Flopsstuff/voistic/(list of files, cad)

Other CAD files:
cad/voistic - tube.stl
cad/voistic - cap.stl
