Flopsstuff/voistic/(commit log)

2026-11-01 🎉 Initial commit
    voistic is a one-button Wi-Fi remote: an ESP32-S3 button that sleeps, recognises a
    gesture and talks to a Go server on the LAN. A hold streams the voice to the server,
    which transcribes it through Groq and pastes it into the active window. New firmware
    goes over the air, with rollback.
2026-11-01 📐 Add the case models, Wi-Fi signal reports and photos
    The tube and the cap are Onshape custom features, with the STLs as
    exported from them, and .mcp.json connects the FeatureScript MCP server.
    The button reports its Wi-Fi signal to the server. Photos and a short
    video show the parts and the prototype at work.
    [voistic - cap.stl, voistic - tube.stl]
2026-11-02 📐 Shrink the case and give the cap a snap-fit skirt
    The printed case fit with room to spare and its cap fell off. The body is
    now 22 × 18 × 80 mm with a 1 mm wall. The cap has a skirt all around with
    bumps that snap into dimples in the side walls, and the plate only presses
    on the stack.
    Claude-Session: https://claude.ai/code/session_01TWqRvKSs74rjiaw7r7Vu55
    [voistic - cap.stl, voistic - tube.stl]
2026-11-02 🪟 Run on Windows and publish releases from CI
    The server pastes and presses keys through Win32 on Windows and starts at
    login as a scheduled task, running a build with no console window. A new
    `key` action presses enter, tab or esc on macOS and Windows, so a config
    no longer depends on the system.
    CI tests the server on Linux, macOS and Windows and builds the firmware.
    A v* tag also publishes a release with an archive for each system, both
    firmwares and their checksums.
    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
2026-11-02 🔗 Pair only on request and share a network between servers
    A button now pairs only while `voistic pair` is waiting, even when the
    config names it. The firmware used to take the first server that answered
    mDNS, so a second server on the network could block pairing, or block a
    button whose server had moved. It now tries each one that answers.
    CI needed two fixes: the firmware platform is pinned, since newer ones
    bring Arduino core 3, which has no MDNS.IP, and the tests of Unix file
    modes are skipped on Windows, which has none.
    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
    [client.cpp]
2026-11-02 ✨ Add paste_suffix to follow a pasted transcript
    A space there keeps the next phrase from sticking to the last one.
    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
2026-11-02 🔘 Pick the server's own subnet and cancel pairing with a press
    A server can list addresses the button can't reach, such as a virtual
    adapter's, and MDNS.IP() only gives the first. The firmware now reads the
    whole list from ESP-IDF and takes the address on its own subnet.
    A 2 s press now gives up on pairing, read from the button's edges so that
    it counts during a blocking network query.
    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
2026-11-02 📡 Keep mDNS on the primary network card and renew it for pairing
    Left to itself, the system could join the mDNS group on a virtual adapter
    such as WSL's, so the server heard nothing and logged no error. It now uses
    the card of the default route and sends out only that address.
    Each `voistic pair` renews the socket, because one can go deaf unnoticed,
    as on macOS after a rebuild, and pairing shouldn't need a restart. The log
    now shows the pairing window with its address and where a button came from.
    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
2026-11-02 📸 Show the printed case and tell the story of the build
    The README now shows the finished case, and docs/hardware.md follows the
    build from loose parts through the taped prototype to the printed case.
    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
2026-11-03 📟 Tell boards apart on the server
    A button now reports its board, and where it can measure it, its battery.
    The store keeps both, and `voistic devices` shows them. Older firmware
    reports nothing, and every such button is a XIAO.
    Firmware images are named after the button and its board, such as
    voistic-25bc-iot-button-c6.bin. `voistic firmware` refuses an image whose
    chip isn't the button's, and the server won't offer one for another board.
    `deep_sleep_after` in a device's config sets how long a button that can
    stays connected after a press, 30 minutes by default. Answers carry it as
    `awake_s`.
    Claude-Session: https://claude.ai/cod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
2026-11-03 🔘 Run voistic on the Seeed IoT Button V2
    A second board, env c6: an ESP32-C6 with an analog DFRobot SEN0487 on its
    test pads, read by the ADC in continuous mode, and an 18650. Its RGB LED
    shows the XIAO's colours, and the red/blue LED beside it shows pairing as
    a siren and the wait for the network during a hold. It measures its
    battery at every wake.
    Between presses it waits in light sleep with Wi-Fi connected, so a press
    reaches the server in tens of milliseconds, and deep-sleeps after the time
    the server asks for. That needs ESP-IDF built with power management, so
    env c6 rebuilds it from sdkconfig.c6.defaults, which also drops the
    second-long check of a DHCP address.
    All boards now bu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
    [partitions-c6.csv]
2026-11-03 🔬 Keep the research on the IoT Button V2
    The diagnostic firmware and notes from working out the board: the pinout
    of the test pads, checked pad by pad, the LEDs, and the analog microphone
    recorded with and without Wi-Fi. tools/record.py fetches recordings from
    the test firmware over USB.
    Claude-Session: https://claude.ai/code/session_01TWqRvHvo5NtxcbHbnjaVNg
2026-11-03 📸 Show the IoT Button V2 with its microphone
    Three photos for docs/iot-button-c6.md: the button in a hand while it
    records, the open case with the wires from the test pads, and the
    microphone standing beside the 18650, which came with the button. The
    README puts the open case beside the XIAO's parts, and the one in a hand
    beside the XIAO's two.
    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
2026-11-03 👷 Pin the PlatformIO that the C6 build calls
    After compiling ESP-IDF for env c6, pioarduino's platform runs its own copy
    of PlatformIO from ~/.platformio/penv. That copy says 6.2.0.post1, which
    the platform reads as older than its minimum of 6.2.0, so the build
    removed the platform and failed. CI now installs the platform first and
    puts PlatformIO 6.2.0 into that environment, as was done by hand locally.
    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
2026-11-06 🔌 Configure buttons over USB, update from releases, keep every press
    `voistic usb` talks to a button on this computer's USB and replaces
    tools/board.py. It restarts the board with an RTS pulse, as esptool does,
    and the firmware's new `hello` holds it awake with its button ignored
    until `bye`. `setup` takes this computer's Wi-Fi and its saved password
    (keychain, netsh or nmcli), pairs through the control socket's new
    /adopt, which needs no window since holding the button is the proof, and
    has the button check in. `wifi`, `pair`, `check`, `brightness`, `update`,
    `log` and `reset` do one step each, and `voistic help` lists everything.
    `voistic update` replaces the server with the latest Git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
    [client.cpp, client.h, gesture.cpp, gesture.h, leds.cpp, leds.h, link.cpp, link.h]
2026-11-06 📖 Give Groq a vocabulary, and the help a link
    `groq.prompt` in the config goes with every transcription: the names,
    terms and spellings to expect, up to Groq's 224 tokens. It guides the
    model rather than instructing it. `groq.replace` then swaps whole words
    and phrases, in any case, for how they should be spelled, longer ones
    first, after `ignore`. Go's \b only knows ASCII, so word edges are
    checked by hand, which keeps "сяомка" whole while "сяо" becomes XIAO.
    On the real API with a phrase spoken by macOS's Milena: without them,
    "войстик" stayed and "клод код" came out as "код"; with them, "voistic"
    came through the replacement and the prompt pulled in "Claude C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
2026-11-06 📝 Keep the changelog with every change
    AGENTS.md says to add a line under "## Unreleased" in CHANGELOG.md with
    each change a user or button owner would notice, in the same commit,
    and how a release turns that heading into its version and tag.
